TTNApeldoorn/esp32-p1-node/hardware/esp32-p1-node-housing/readme.md

# P1-LoRaWAN sensor Housing
The P1-Sensor is designed for a Hammond 1591XXBSFL Enclosure. This enclosure is a black RAL 7011 flanged enclosure with the dimensions 113.82 x 63.32 x 28.25 mm. The PCB, that is screwed using parkers, to the flanged lid of the box, is holding all components and connectors together so that only holes shall be made in the box at the required positions.

As the TTGO LORA32 has an Oled display the box a window so that the information on the display can be read. Because manually created holes in PVC or ABS are difficult to make with smooth and straight edges, a 3D-printed PLA frame is used as a cover around the window trough wchich the display can be viewed.

This document will describe all measures for aproperiate holes in the flanged Hammond box and the files for the 3D printed frame.

*All measures are in millimeters (mm)*

## Dimensions of holes
This paragraph will present schematics of all dimensions and measures of the holes that shall be applied to the Hammond box.

For orienteering purposes the following image shows which sides are documented and how they are named in thif description.

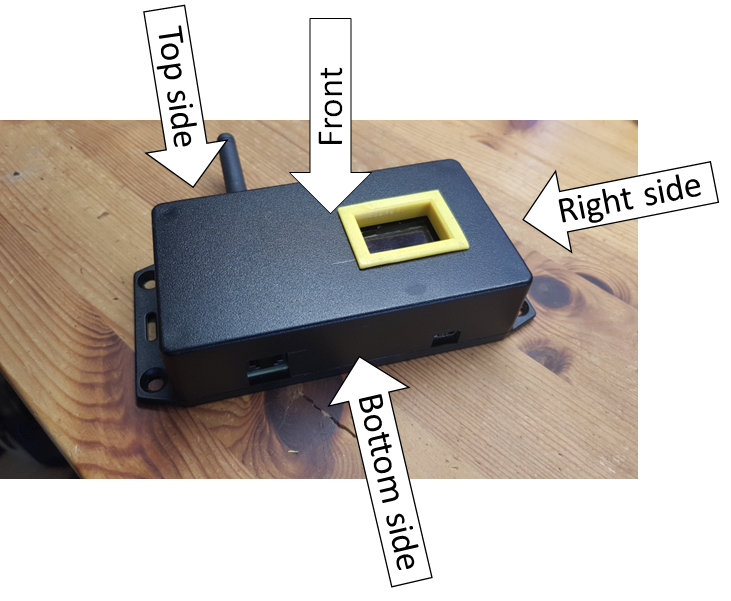
[picture p2: hardware/esp32-p1-node-housing/CaseDefinitions.png]
Box-side-naming


### Bottom side
On the bottom side connectors are situated for the serial connection to the P1-interface (left) using a RJ12 connectort and a mini-USB connector for a small 5V power supply. 

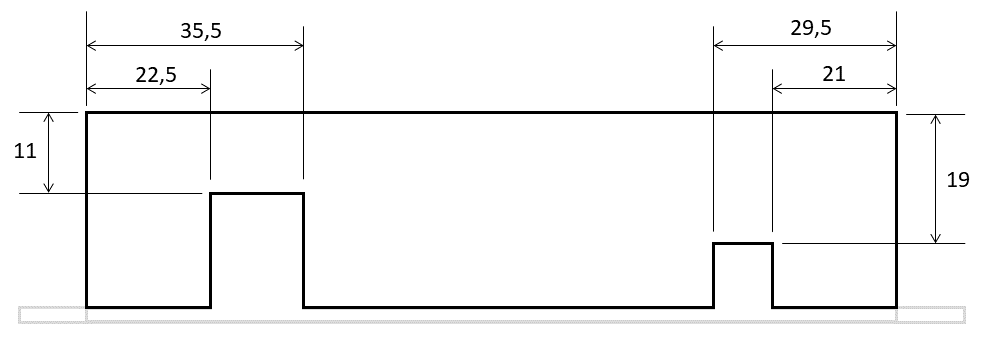
[picture p3: hardware/esp32-p1-node-housing/CaseSideBottom.png]
Box-CaseSideBottom


### Top side
At the top side a hole is located to allow access to the SMA antenna connector. 

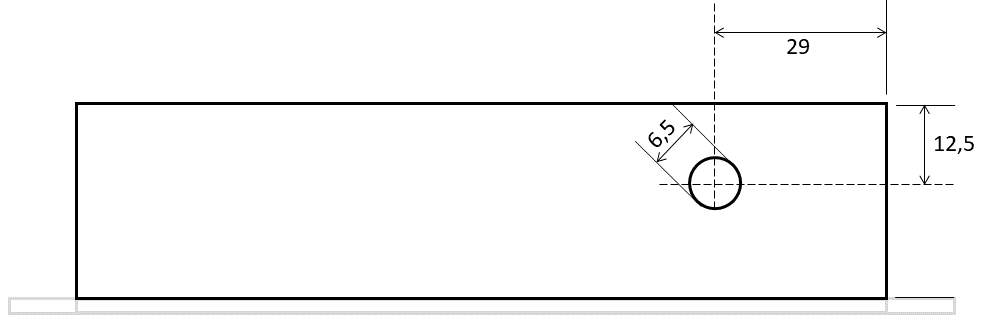
[picture p4: hardware/esp32-p1-node-housing/CaseSideTopAlternative.png]
Box-CaseSideTopAlternative


### Right side [optional]
At the right side a hole to access micro-USB connector of the TTGO LORA32 board may be added. This hole is optional.

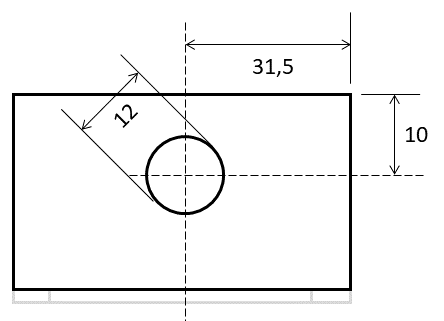
[picture p5: hardware/esp32-p1-node-housing/CaseSideRight.png]
Box-CaseSideRight


### Front side
At the front of the box the display is located of the TTGO LoRa32 board. This rectangular shaped window will be used in combination with a 3D printed frame. The 3D printed frame can be downloaded below. 

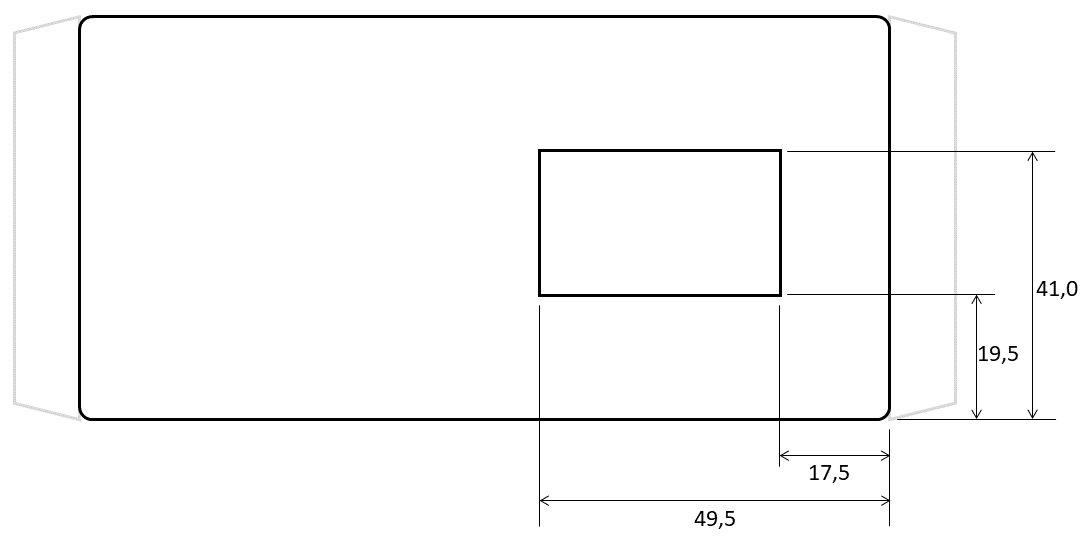
[picture p6: hardware/esp32-p1-node-housing/CaseFront.png]
Dimensions window frontside


To aid the creation of the window the following holes can be drilled:

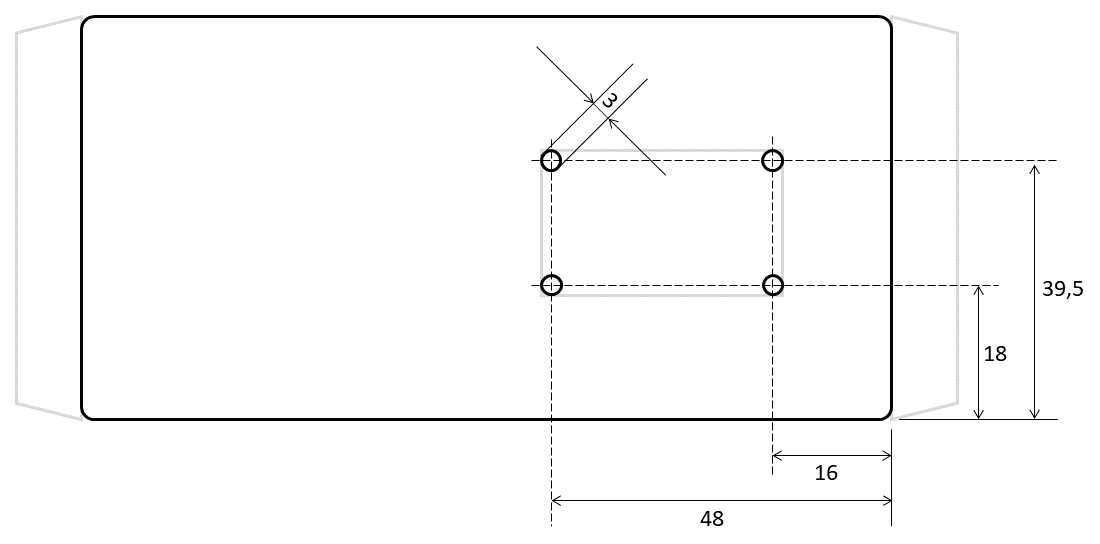
[picture p7: hardware/esp32-p1-node-housing/CaseFrontAid.png]
location-dimenstions support-holes window frontside


## 3D printed frame
The 3D printed frame is made available as <a href="https://www.sketchup.com/" target="_blank">Sketchup</a> source file and STL-file for download. 

 - <a href="https://www.sketchup.com/" target="_blank">Sketchup</a> source file: <a download="Venster_003.skp" href="Venster_003.skp" title="Sketchup file, right-click and download.">Venster_003.skp</a>
 - <a href="https://en.wikipedia.org/wiki/STL_(file_format)" target="_blank">STL</a>-file: <a download="Venster_003_fixed.stl" href="Venster_003_fixed.stl" title="STL-file">Venster_003_fixed.stl</a>

# License
The TTN-Apeldoorn P1-Node node is free soft- and hardware:
you can redistribute and/or modify it under the terms of a Creative Commons Attribution-NonCommercial 4.0 International License (http://creativecommons.org/licenses/by-nc/4.0/) by TTN-Apeldoorn (https://www.thethingsnetwork.org/community/apeldoorn/) E-mail: ttnapeldoorncoreteam@rfsee.nl

<br />This work is licensed under a <a rel="license" href="http://creativecommons.org/licenses/by-nc/4.0/">Creative Commons Attribution-NonCommercial 4.0 International License</a>.
