TTNApeldoorn/esp32-p1-node/hardware/esp32-p1-node-housing/CaseSideTop.png

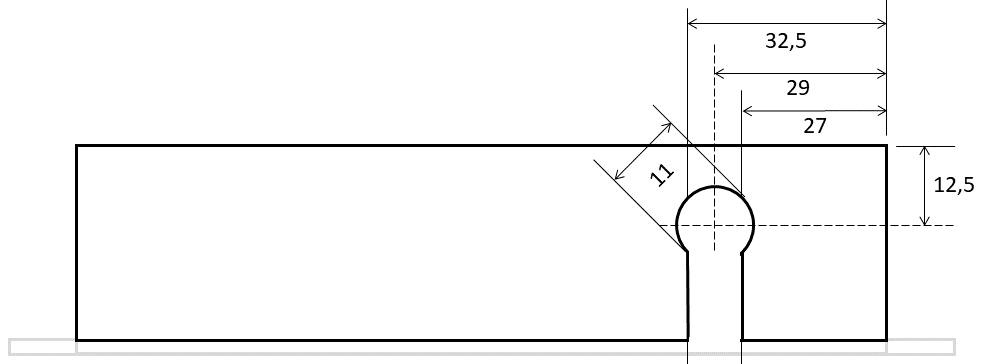
hardware/esp32-p1-node-housing/CaseSideTop.png
