TTNApeldoorn/esp32-p1-node/hardware/bom.md

# BOM
This is the Bill of Materials for the P1-Node. Although this list is created with accuracy in mind it might be incorrect.

Ref | n | Value | Footprint | Shop | Datasheet
----|---|-------|-----------|------|-------------------------------------
C1 | 1 | 10n | SMD:1206_3216 |  RS-Components  | https://nl.rs-online.com/web/p/mlccs-multilayer-ceramic-capacitors/2989220/
D1 | 1 | BAT54S | SMD:SOT-23 |  RS-Components  | https://nl.rs-online.com/web/p/rectifier-diodes-schottky-diodes/5444584/
J1 | 1 | RJ11-6 | RJ12_Amphenol_54601 |  RS-Components  | https://nl.rs-online.com/web/p/ethernet-connectors/1370999/
Q1 | 1 | BC547 (BC847) | SMD:SOT-323_SC-70 (SOT23) |  RS-Components  | https://nl.rs-online.com/web/p/bjt-bipolar-transistors/6900091/
R1,  | 1 | 10K | SMD:R_1206_3216 |  RS-Components  | https://nl.rs-online.com/web/p/surface-mount-fixed-resistors/7219908/
R2, R3, R4, R8 | 1 | 1K | SMD:R_1206_3216 |  RS-Components  | https://nl.rs-online.com/web/p/surface-mount-fixed-resistors/9013724/
R5, R6, R7 | 3 | 180 | SMD:R_1206_3216 |  RS-Components  | https://nl.rs-online.com/web/p/surface-mount-fixed-resistors/7219762/
Housing | 1 |  | Hammond 1591 ABS Enclosure, Flanged |  RS-Components  | https://nl.rs-online.com/web/p/general-purpose-enclosures/8180514/
PCB | 1 |  | Aisler, PCB & Stencil |  Aisler  | http://www.aisler.net
header | 2 | FemalePCBHeader | 1 Row Straight PCB Socket |  RS-Components  | https://nl.rs-online.com/web/p/pcb-sockets/0252399/
U1 | 1 | TTGO_LoRa32_V11 | TTGO LoRa32 |  Tinytronics  | https://www.tinytronics.nl/shop/nl/platforms/ttgo/lilygo-ttgo-lora32-868mhz-esp32
Cable | 1 | RJ11 | InLine Modularkabel RJ12, Male/Male, 6adrig, 6P6C, 1m |  Netwerkwinkel.com  | https://www.netwerkwinkel.com/Verleng--en-aansluitkabels/Telefoonkabels/RJ10---RJ11---RJ12-kabels/InLine/InLine-Modularkabel-RJ12-Male-Male-6adrig-6P6C-2m-18842-p_12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
PSU | 1 | 5V-miniUSB-Adapter | 5W Plug In Power Supply 5V dc, 1A |  RS-Components  | https://nl.rs-online.com/web/p/ac-dc-adapters/1217116/
miniUSB | 1 | Type B Mini USB Connector | Through Hole Mount Receptacle  |  RS-Components  | https://nl.rs-online.com/web/p/usb-connectors/6741350/
