TTNApeldoorn/esp32-p1-node/hardware/esp32-p1-node-housing/Venster_003_fixed.stl

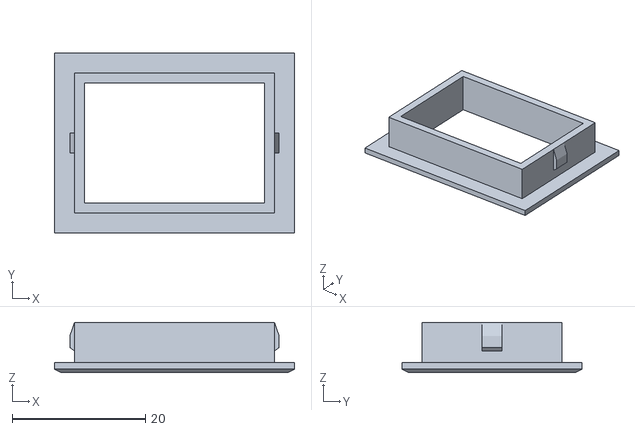
[picture p9: CAD file, 2020-08-23]
hardware/esp32-p1-node-housing/Venster_003_fixed.stl
36.0 x 27.0 x 7.50
