TTNApeldoorn/esp32-p1-node/(list of files, cad)

Other CAD files:
hardware/esp32-p1-node-housing/Venster_003.skp
