TTNApeldoorn/esp32-p1-node/hardware/instructions.md

# Building instructions
This file describes how to construct the P1-Node.
