TTNApeldoorn/esp32-p1-node/(commit log)

2020-07-04 Inital commit
    [esp32-p1-node-board.kicad_pcb, esp32-p1-node-board.sch]
2020-07-26 Update PCB
    [esp32-p1-node-board.kicad_pcb, esp32-p1-node-board.sch]
2020-07-27 Added first release of PCB for revision
    [esp32-p1-node-board.kicad_pcb, esp32-p1-node-board.sch]
2020-07-30 Updated PCB with jumper for polarity and added holes to stencil
    [esp32-p1-node-board.kicad_pcb, esp32-p1-node-board.sch]
2020-08-03 Added levelconverter for reversed logic input
    [esp32-p1-node-board.kicad_pcb, esp32-p1-node-board.sch]
2020-08-05 Corrected Transistor and mini USB connector for version 0.9
    [esp32-p1-node-board.kicad_pcb, esp32-p1-node-board.sch]
2020-08-10 Added TTN-Logo
    [esp32-p1-node-board.kicad_pcb]
2020-08-10 Update to pre-1.0
    [esp32-p1-node-board.kicad_pcb]
2020-08-23 Documentation update on housing
    [InitalSketch_001.skp, Venster_003.skp, Venster_003_fixed.stl]
2020-08-23 Update last PCB
    [esp32-p1-node-board.kicad_pcb, esp32-p1-node-board.sch]
2020-11-23 debug print hash disabled
