TTNApeldoorn/esp32-p1-node/(notices)

Notices in the files:
hardware/esp32-p1-node-board/esp32-p1-node-board/esp32-p1-node-board.kicad_pcb:
CC BY-NC-SA 3.0 NL
